rkarl2/Zyqn-7000-test/pcb/zynq_test/zynqGerbers/Required_impedance_control.xlsx

Signal Layer | Reference Layer | Impedance Type | Trace Width（mil) | Trace Spacing（mil) | Impedance(ohm)±10% | Position
L1 | L2 | Differential Pair (Non coplanar) | 4.35039 | 11.81102 | 100
L8 | L7 | Differential Pair (Non coplanar) | 4.35039 | 11.81102 | 100
L1 | L2 | Differential Pair (Non coplanar) | 5.35039 | 11.81102 | 90
L1 | L2 | Differential Pair (Non coplanar) | 5.85827 | 5.90551 | 80
L8 | L7 | Differential Pair (Non coplanar) | 5.85827 | 5.90551 | 80
L8 | L7 | Single Ended (Non coplanar) | 7.25984 |  | 40
L1 | L2 | Single Ended (Non coplanar) | 7.25984 |  | 40
L6 | L5/7 | Single Ended (Non coplanar) | 4.45 |  | 40
L4 | L5/3 | Single Ended (Non coplanar) | 4.45 |  | 40
L8 | L7 | Single Ended (Non coplanar) | 4.66142 |  | 50
L1 | L2 | Single Ended (Non coplanar) | 4.66142 |  | 50
