rkarl2/Zyqn-7000-test/pcb/zynq_test/zynq_test.kicad_pcb

## KiCad design pcb/zynq_test/zynq_test.kicad_pcb (2025-10-05)

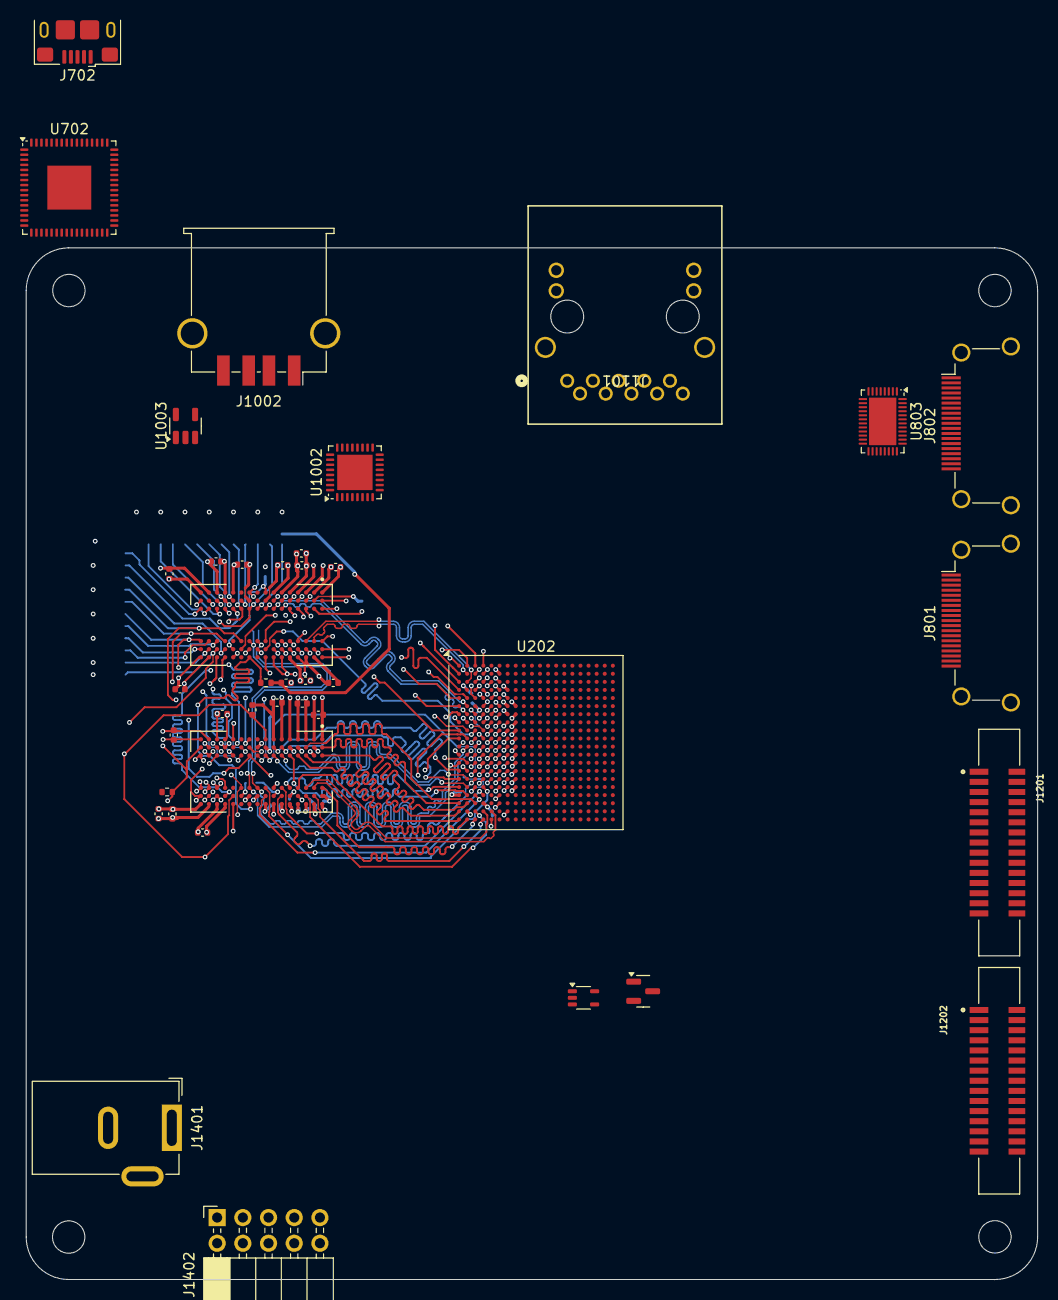
[picture p3: board zynq_test.kicad_pcb from above]

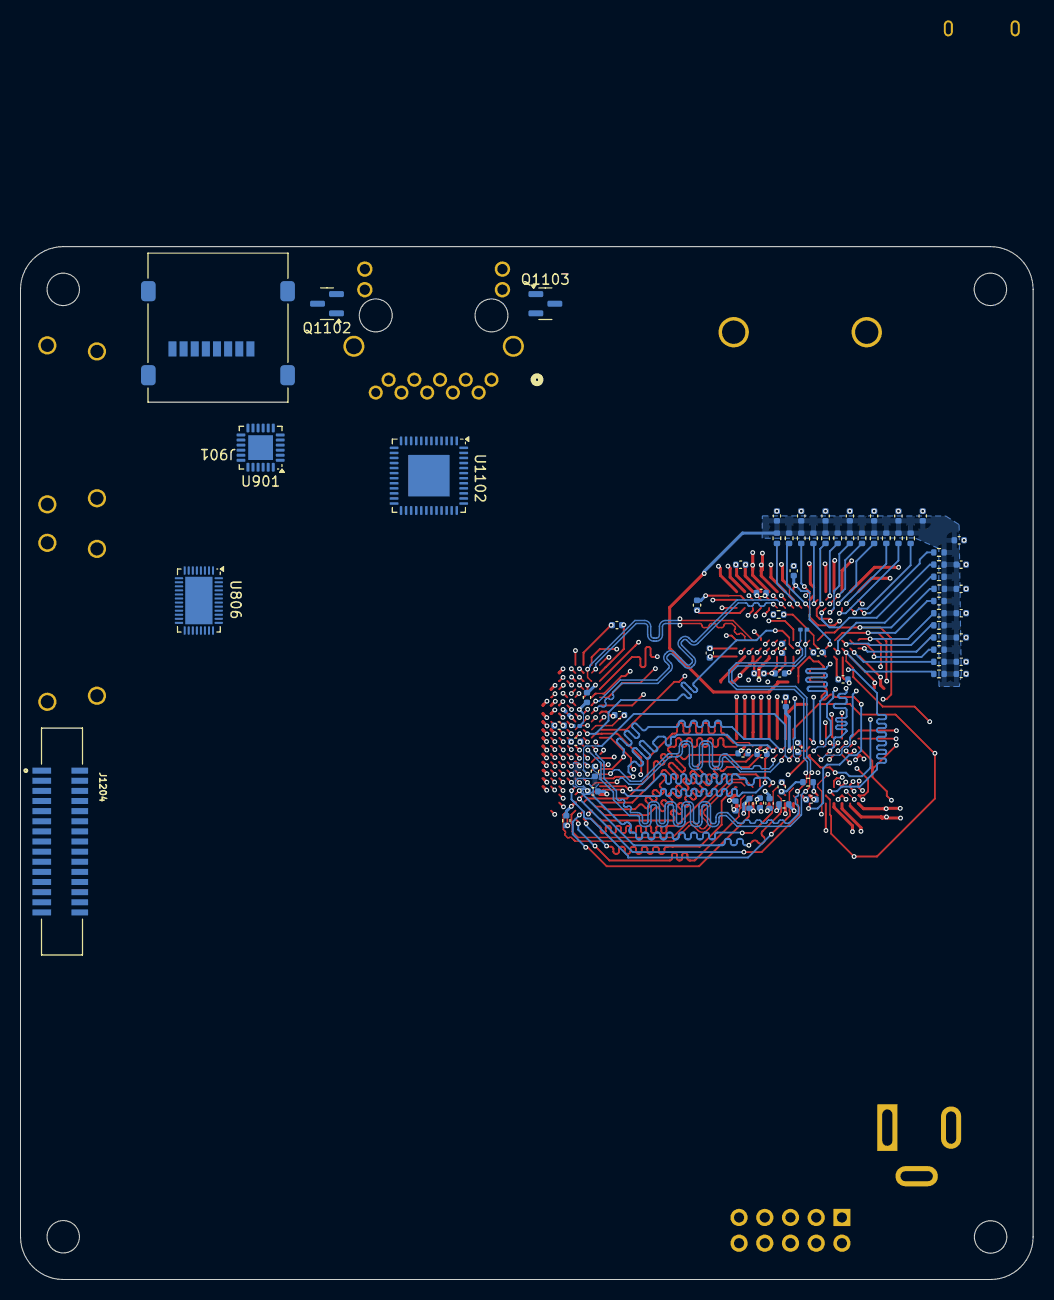
[picture p4: board zynq_test.kicad_pcb from below]

Board: 8 copper layers, 100.0 x 102.0 mm, 118 parts (78 on the bottom side), 203 nets.

Parts:
C401, C403, C406, C409, C411, C501, C502, C537, C538, C617, C620, C622, C624: 470n; C_0402_1005Metric
C402, C405, C408, C412, C415, C416, C539, C540, C627, C630: 4u7; C_0402_1005Metric
C404, C407, C410, C413, C414: 100n; C_0402_1005Metric
C503, C504, C505, C506, C507, C508, C509, C510, C511, C512, C513, C514, C515, C516, C517, C518, C519, C520, C521, C522, C523, C524, C525, C526, C527, C528, C530, C532, C533, C534, C535, C536: 47n; C_0402_1005Metric
C529, C531: 10n; C_0402_1005Metric
C632: 100u; C_0402_1005Metric
J702: USB_B_Micro; USB_Micro-B_Amphenol_10118193-0001LF_Horizontal
J801, J802: HDMI_A; HDMI_A_Amphenol_10029449-x01xLF_Horizontal
J901: A-MicroTF-1.85A; microSD_HC_Molex_47219-2001
J1002: USB_A; USB_A_TE_292303-7_Horizontal
J1101: RJ45_JK0654219; ARJM11C7-502-AB-ER2-T_ABR
J1201, J1202, J1204: 1-1734248-5; TE_1-1734248-5
J1401: Barrel_Jack; BarrelJack_GCT_DCJ200-10-A_Horizontal
J1402: Conn_02x05_Odd_Even; PinSocket_2x05_P2.54mm_Horizontal
Q1102, Q1103, Q1104: 2N7002E; SOT-23
R401, R402, R406: 80R; R_0201_0603Metric
R403: 4k7; R_0402_1005Metric
R404, R405: 240R; R_0402_1005Metric
R407, R408, R409, R410, R411, R412, R413, R414, R415, R416, R417, R418, R419, R420, R421, R422, R423, R424, R425, R426, R427, R428, R429, R430: 40R; R_0402_1005Metric
U202: XC7Z020-2CLG400I; Zynq_Z7020-2CLG400I_W_Delay
U401, U402: MT41K256M16TW-107; BGA96C80P9X16_1400X800X120_pinDelays
U702: FT2232HQ; QFN-64-1EP_9x9mm_P0.5mm_EP4.35x4.35mm
U803, U806: TDP1204RNQR; Texas_RNQ0040A_WQFN-40-1EP_6x4mm_P0.4mm_EP4.7x2.7mm
U901: TXS02612RTW; WQFN-24-1EP_4x4mm_P0.5mm_EP2.45x2.45mm
U1002: TUSB1210-Q1; VQFN-32-1EP_5x5mm_P0.5mm_EP3.5x3.5mm
U1003: AP22816AKBWT; SOT-23-5
U1102: LAN8830; VQFN-48-1EP_7x7mm_P0.5mm_EP4.1x4.1mm
U1405: 74LVC1G17; Texas_R-PDSO-G5_DCK-5

Connections:
+1V0: J1402.4, U202.G7 (VCCPINT), U202.G11 (VCCBRAM), U202.G13 (VCCINT), U202.H10 (VCCBRAM), U202.H12 (VCCINT), U202.J7 (VCCPINT), U202.J13 (VCCINT), U202.K12 (VCCINT), U202.L7 (VCCPINT), U202.L13 (VCCINT), U202.M12 (VCCINT), U202.N7 (VCCPINT), U202.N13 (VCCINT), U202.P8 (VCCPINT), U202.P12 (VCCINT), U202.R7 (VCCPINT), U202.R13 (VCCINT)
+1V8: J1402.6, U202.A13 (VCCO_MIO1_501), U202.B16 (VCCO_MIO1_501), U202.D12 (VCCO_MIO1_501), U202.E15 (VCCO_MIO1_501), U202.F8 (VCCPAUX), U202.G9 (VCCPAUX), U202.H8 (VCCPAUX), U202.J9 (VCCADC_0), U202.J11 (VCCAUX), U202.K8 (VCCPAUX), U202.L11 (VCCAUX), U202.M8 (VCCPAUX), U202.N9 (VCCAUX), U202.N11 (VCCAUX), U202.P10 (VCCAUX), U202.R9 (VCCAUX), U202.T8 (VCCO_13), U202.U11 (VCCO_13), U202.W7 (VCCO_13), U202.Y10 (VCCO_13), U901.5 (V_{CCA}), U1002.11 (CS), U1002.14 (CFG), U1002.27 (RESETB), U1002.28 (V_{DD18}), U1002.30 (V_{DD18}), U1002.32 (V_{DDIO}), U1102.17 (VDDIO), U1102.24 (VDDIO), U1102.28 (VDDIO), U1102.35 (VDDIO), U1102.41 (VDDIO)
+1V8_FTDI: U702.12 (VCORE), U702.37 (VCORE), U702.49 (VREGOUT), U702.64 (VCORE)
+1V35: C501.1, C502.1, C503.1, C504.1, C505.1, C506.1, C507.1, C508.1, C509.1, C510.1, C511.1, C512.1, C513.1, C514.1, C515.1, C516.1, C517.1, C518.1, C519.1, C520.1, C521.1, C522.1, C523.1, C524.1, C525.1, C526.1, C527.1, C528.1, C530.1, C532.1, C533.1, C534.1, C535.1, C536.1, C537.1, C538.1, C539.1, C540.1, C617.1, C620.1, C622.1, C624.1, C627.1, C630.1, C632.1, J1402.8, R401.1, U202.A3 (VCCO_DDR_502), U202.D2 (VCCO_DDR_502), U202.E5 (VCCO_DDR_502), U202.G1 (VCCO_DDR_502), U202.H4 (VCCO_DDR_502), U202.L3 (VCCO_DDR_502), U202.P2 (VCCO_DDR_502), U202.R5 (VCCO_DDR_502), U202.U1 (VCCO_DDR_502), U202.V4 (VCCO_DDR_502), U401.A1 (VDDQ), U401.A8 (VDDQ), U401.B2 (VDD), U401.C1 (VDDQ), U401.C9 (VDDQ), U401.D2 (VDDQ), U401.D9 (VDD), U401.E9 (VDDQ), U401.F1 (VDDQ), U401.G7 (VDD), U401.H2 (VDDQ), U401.H9 (VDDQ), U401.K2 (VDD), U401.K8 (VDD), U401.N1 (VDD), U401.N9 (VDD), U401.R1 (VDD), U401.R9 (VDD), U402.A1 (VDDQ), U402.A8 (VDDQ), U402.B2 (VDD), U402.C1 (VDDQ), U402.C9 (VDDQ), U402.D2 (VDDQ), U402.D9 (VDD), U402.E9 (VDDQ), U402.F1 (VDDQ), U402.G7 (VDD), U402.H2 (VDDQ), U402.H9 (VDDQ), U402.K2 (VDD), U402.K8 (VDD), U402.N1 (VDD), U402.N9 (VDD), U402.R1 (VDD), U402.R9 (VDD)
+3V3: J901.4 (VDD), J1101.11 (L_LED_A), J1101.13 (R_LED_A), J1201.15, J1201.15_1 (15__1), J1202.15, J1202.15_1 (15__1), J1204.15, J1204.15_1 (15__1), J1402.10, U202.B6 (VCCO_MIO0_500), U202.C19 (VCCO_35), U202.D7 (VCCO_MIO0_500), U202.F18 (VCCO_35), U202.H14 (VCCO_35), U202.J17 (VCCO_35), U202.K6 (VCCO_0), U202.K20 (VCCO_35), U202.M6 (CFGBVS_0), U202.M16 (VCCO_35), U202.N6 (RSVDVCC3), U202.N19 (VCCO_34), U202.R6 (RSVDVCC2), U202.R15 (VCCO_34), U202.T6 (RSVDVCC1), U202.T18 (VCCO_34), U202.V14 (VCCO_34), U202.W17 (VCCO_34), U202.Y20 (VCCO_34), U702.20 (VCCIO), U702.31 (VCCIO), U702.42 (VCCIO), U702.50 (VREGIN), U702.56 (VCCIO), U803.1 (VCC), U803.6 (VCC), U803.14 (VIO), U803.20 (VCC), U803.28 (VCC), U806.1 (VCC), U806.6 (VCC), U806.14 (VIO), U806.20 (VCC), U806.28 (VCC), U901.17 (VCC_{B1}), U901.21 (VCC_{B0}), U1002.20 (V_{DD33}), U1002.21 (V_{BAT}), U1405.5 (VCC)
+5V: J801.18 (+5V), J802.18 (+5V), J1402.2, U1003.3 (IN)
+5V_{USB_OTG}: J1002.1 (VBUS), U1002.22 (V_{BUS}), U1003.1 (OUT), U1003.5 (OUT)
+V_{TT} 0V675: C402.1, C403.1, C404.1, C405.1, C406.1, C407.1, C408.1, C409.1, C410.1, C411.1, C412.1, C413.1, C414.1, C415.1, C416.1, R407.1, R408.1, R409.1, R410.1, R411.1, R412.1, R413.1, R414.1, R415.1, R416.1, R417.1, R418.1, R419.1, R420.1, R421.1, R422.1, R423.1, R424.1, R425.1, R426.1, R427.1, R428.1, R429.1, R430.1
/Boot/SD0.CLK: J901.5 (CLK), U901.9 (CLKA), U901.19 (CLK_{B0})
/Boot/SD0.CMD: J901.3 (CMD), U202.C17 (PS_MIO41_501), U901.4 (CMDA), U901.20 (CMD_{B0})
/Boot/SD0.DAT0: J901.7 (DAT0), U901.18 (DAT0_{B0})
/Boot/SD0.DAT1: J901.8 (DAT1), U901.16 (DAT1_{B0})
/Boot/SD0.DAT2: J901.1 (DAT2), U901.23 (DAT2_{B0})
/Boot/SD0.DAT3: J901.2 (DAT3/CD), U901.22 (DAT3_{B0})
/Boot/SD0.DATA-0: U202.E12 (PS_MIO42_501), U901.6 (DAT0A)
/Boot/SD0.DATA-1: U202.A9 (PS_MIO43_501), U901.7 (DAT1A)
/Boot/SD0.DATA-2: U202.F13 (PS_MIO44_501), U901.1 (DAT2A)
/Boot/SD0.DATA-3: U202.B15 (PS_MIO45_501), U901.3 (DAT3A)
/Cameras/CAM0.GPIO1.: J1201.11, J1201.11_1 (11__1), J1201.12, J1201.12_1 (12__1)
/Cameras/CAM1.GPIO1.: J1202.11, J1202.11_1 (11__1), J1202.12, J1202.12_1 (12__1)
/Cameras/CAM2.GPIO1.: J1204.11, J1204.11_1 (11__1), J1204.12, J1204.12_1 (12__1)
/Cameras/CAM2.TX.0_N: J1204.2, J1204.2_1 (2__1)
/Cameras/CAM2.TX.0_P: J1204.3, J1204.3_1 (3__1)
/Cameras/CAM2.TX.1_N: J1204.5, J1204.5_1 (5__1)
/Cameras/CAM2.TX.1_P: J1204.6, J1204.6_1 (6__1)
/Cameras/CAM2.TX.CLK_N: J1204.8, J1204.8_1 (8__1)
/Cameras/CAM2.TX.CLK_P: J1204.9, J1204.9_1 (9__1)
/Cameras/CAM_RX.0.CAM_CLK_N: J1201.8, J1201.8_1 (8__1), U202.L20 (IO_L9N_T1_DQS_AD3N_35)
/Cameras/CAM_RX.0.CAM_CLK_P: J1201.9, J1201.9_1 (9__1), U202.L19 (IO_L9P_T1_DQS_AD3P_35)
/Cameras/CAM_RX.0.CAM_D0_N: J1201.2, J1201.2_1 (2__1), U202.F20 (IO_L15N_T2_DQS_AD12N_35)
/Cameras/CAM_RX.0.CAM_D0_P: J1201.3, J1201.3_1 (3__1), U202.F19 (IO_L15P_T2_DQS_AD12P_35)
/Cameras/CAM_RX.0.CAM_D1_N: J1201.5, J1201.5_1 (5__1), U202.H20 (IO_L17N_T2_AD5N_35)
/Cameras/CAM_RX.0.CAM_D1_P: J1201.6, J1201.6_1 (6__1), U202.J20 (IO_L17P_T2_AD5P_35)
/Cameras/CAM_RX.0.I2C_CLK: J1201.13, J1201.13_1 (13__1), U202.K17 (IO_L12P_T1_MRCC_35)
/Cameras/CAM_RX.0.I2C_SDA: J1201.14, J1201.14_1 (14__1), U202.K18 (IO_L12N_T1_MRCC_35)
/Cameras/CAM_RX.1.CAM_CLK_N: J1202.8, J1202.8_1 (8__1), U202.W15 (IO_L10N_T1_34)
/Cameras/CAM_RX.1.CAM_CLK_P: J1202.9, J1202.9_1 (9__1), U202.V15 (IO_L10P_T1_34)
/Cameras/CAM_RX.1.CAM_D0_N: J1202.2, J1202.2_1 (2__1), U202.Y19 (IO_L17N_T2_34)
/Cameras/CAM_RX.1.CAM_D0_P: J1202.3, J1202.3_1 (3__1), U202.Y18 (IO_L17P_T2_34)
/Cameras/CAM_RX.1.CAM_D1_N: J1202.5, J1202.5_1 (5__1), U202.Y17 (IO_L7N_T1_34)
/Cameras/CAM_RX.1.CAM_D1_P: J1202.6, J1202.6_1 (6__1), U202.Y16 (IO_L7P_T1_34)
/Cameras/CAM_RX.1.I2C_CLK: J1202.13, J1202.13_1 (13__1), U202.V20 (IO_L16P_T2_34)
/Cameras/CAM_RX.1.I2C_SDA: J1202.14, J1202.14_1 (14__1), U202.W20 (IO_L16N_T2_34)
/Cameras/CAM_TX.2.I2C_CLK: J1204.13, J1204.13_1 (13__1), U202.T14 (IO_L5P_T0_34)
/Cameras/CAM_TX.2.I2C_SDA: J1204.14, J1204.14_1 (14__1), U202.T15 (IO_L5N_T0_34)
/ETHERNET/ETH0.MDC: U202.C10 (PS_MIO52_501), U1102.37 (MDC)
/ETHERNET/ETH0.MDIO: U202.C11 (PS_MIO53_501), U1102.38 (MDIO)
/ETHERNET/ETH0_INT: U202.K14 (IO_L20P_T3_AD6P_35), U1102.39 (INT_N/GPIO5)
/ETHERNET/ETH_1V1: U1102.4 (VDDAL), U1102.9 (VDDAL), U1102.47 (VDDAL_PLL)
/ETHERNET/ETH_A_3V3: U1102.1 (VDDAH), U1102.12 (VDDAH)
/ETHERNET/ETH_TX1_N: J1101.2 (TRD1-), U1102.3 (TXRXM_A)
/ETHERNET/ETH_TX1_P: J1101.1 (TRD1+), U1102.2 (TXRXP_A)
/ETHERNET/ETH_TX2_N: J1101.4 (TRD2-), U1102.6 (TXRXM_B)
/ETHERNET/ETH_TX2_P: J1101.3 (TRD2+), U1102.5 (TXRXP_B)
/ETHERNET/ETH_TX3_N: J1101.8 (TRD3-), U1102.8 (TXRXM_C)
/ETHERNET/ETH_TX3_P: J1101.7 (TRD3+), U1102.7 (TXRXP_C)
/ETHERNET/ETH_TX4_N: J1101.10 (TRD4-), U1102.11 (TXRXM_D)
/ETHERNET/ETH_TX4_P: J1101.9 (TRD4+), U1102.10 (TXRXP_D)
/ETHERNET/ETH_VDD_1V1: U1102.23 (VDD), U1102.27 (VDD), U1102.31 (VDD), U1102.40 (VDD)
/HDMI/HDMI.CTR.SCL: U202.J16 (IO_L24N_T3_AD15N_35), U803.21 (SCL/CFG0), U806.21 (SCL/CFG0)
/HDMI/HDMI.CTR.SDA: U202.K16 (IO_L24P_T3_AD15P_35), U803.22 (SDA/CFG1), U806.22 (SDA/CFG1)
/HDMI/HDMI.EN: U202.L16 (IO_L11P_T1_SRCC_35), U803.7 (EN), U806.7 (EN)
/HDMI/HDMI.RX.CLK_N: U202.G18 (IO_L16N_T2_35), U806.30 (OUT_CLKN)
/HDMI/HDMI.RX.CLK_P: U202.G17 (IO_L16P_T2_35), U806.31 (OUT_CLKP)
/HDMI/HDMI.RX.D0_N: U202.G15 (IO_L19N_T3_VREF_35), U806.33 (OUT_D0N)
/HDMI/HDMI.RX.D0_P: U202.H15 (IO_L19P_T3_35), U806.34 (OUT_D0P)
/HDMI/HDMI.RX.D1_N: U202.F17 (IO_L6N_T0_VREF_35), U806.36 (OUT_D1N)
/HDMI/HDMI.RX.D1_P: U202.F16 (IO_L6P_T0_35), U806.37 (OUT_D1P)
/HDMI/HDMI.RX.D2_N: U202.D18 (IO_L3N_T0_DQS_AD1N_35), U806.39 (OUT_D2N)
/HDMI/HDMI.RX.D2_P: U202.E17 (IO_L3P_T0_DQS_AD1P_35), U806.40 (OUT_D2P)
/HDMI/HDMI.RX.SCL: U202.J18 (IO_L14P_T2_AD4P_SRCC_35), U806.24 (LV_DDC_SCL)
/HDMI/HDMI.RX.SDA: U202.H18 (IO_L14N_T2_AD4N_SRCC_35), U806.25 (LV_DDC_SDA)
/HDMI/HDMI.TX.CLK_N: U202.E19 (IO_L5N_T0_AD9N_35), U803.19 (IN_CLKN)
/HDMI/HDMI.TX.CLK_P: U202.E18 (IO_L5P_T0_AD9P_35), U803.18 (IN_CLKP)
/HDMI/HDMI.TX.D0_N: U202.D20 (IO_L4N_T0_35), U803.16 (IN_D0N)
/HDMI/HDMI.TX.D0_P: U202.D19 (IO_L4P_T0_35), U803.15 (IN_D0P)
/HDMI/HDMI.TX.D1_N: U202.B20 (IO_L1N_T0_AD0N_35), U803.13 (IN_D1N)
/HDMI/HDMI.TX.D1_P: U202.C20 (IO_L1P_T0_AD0P_35), U803.12 (IN_D1P)
/HDMI/HDMI.TX.D2_N: U202.A20 (IO_L2N_T0_AD8N_35), U803.10 (IN_D2N)
/HDMI/HDMI.TX.D2_P: U202.B19 (IO_L2P_T0_AD8P_35), U803.9 (IN_D2P)
/HDMI/HDMI.TX.HDP: U202.J14 (IO_L20N_T3_AD6N_35), U803.32 (HPD_IN)
/HDMI/HDMI.TX.SCL: U202.G14 (IO_0_35), U803.24 (LV_DDC_SCL)
/HDMI/HDMI.TX.SDA: U202.J15 (IO_25_35), U803.25 (LV_DDC_SDA)
/HDMI/HDMI_SHIELD: J801.SH, J802.SH
/Power/PWR_ON_RST: Q1104.1 (G), U202.C7 (PS_POR_B_500), U1405.4
/Programmer/FTDI_D+: J702.3 (D+), U702.8 (DP)
/Programmer/FTDI_D-: J702.2 (D-), U702.7 (DM)
/USB_OTG/USB0.DATA-0: U202.A14 (PS_MIO32_501), U1002.3 (DATA0)
/USB_OTG/USB0.DATA-1: U202.D15 (PS_MIO33_501), U1002.4 (DATA1)
/USB_OTG/USB0.DATA-2: U202.A12 (PS_MIO34_501), U1002.5 (DATA2)
/USB_OTG/USB0.DATA-3: U202.F12 (PS_MIO35_501), U1002.6 (DATA3)
/USB_OTG/USB0.DATA-4: U202.C16 (PS_MIO28_501), U1002.7 (DATA4)
/USB_OTG/USB0.DATA-5: U202.A10 (PS_MIO37_501), U1002.9 (DATA5)
/USB_OTG/USB0.DATA-6: U202.E13 (PS_MIO38_501), U1002.10 (DATA6)
/USB_OTG/USB0.DATA-7: U202.C18 (PS_MIO39_501), U1002.13 (DATA7)
/USB_OTG/USB0.DIR: U202.C13 (PS_MIO29_501), U1002.31 (DIR)
/USB_OTG/USB0.NXT: U202.E16 (PS_MIO31_501), U1002.2 (NXT)
/USB_OTG/USB0.STP: U202.C15 (PS_MIO30_501), U1002.29 (STP)
/USB_OTG/USB_OTG.D+: J1002.3 (D+), U1002.18 (DP)
/USB_OTG/USB_OTG.D-: J1002.2 (D-), U1002.19 (DM)
/Zynq Dram/DDR_ADDR0: R407.2, U202.N2 (PS_DDR_A0_502), U401.N3 (A0), U402.N3 (A0)
/Zynq Dram/DDR_ADDR1: R409.2, U202.K2 (PS_DDR_A1_502), U401.P7 (A1), U402.P7 (A1)
/Zynq Dram/DDR_ADDR2: R412.2, U202.M3 (PS_DDR_A2_502), U401.P3 (A2), U402.P3 (A2)
/Zynq Dram/DDR_ADDR3: R415.2, U202.K3 (PS_DDR_A3_502), U401.N2 (A3), U402.N2 (A3)
/Zynq Dram/DDR_ADDR4: R418.2, U202.M4 (PS_DDR_A4_502), U401.P8 (A4), U402.P8 (A4)
/Zynq Dram/DDR_ADDR5: R421.2, U202.L1 (PS_DDR_A5_502), U401.P2 (A5), U402.P2 (A5)
/Zynq Dram/DDR_ADDR6: R424.2, U202.L4 (PS_DDR_A6_502), U401.R8 (A6), U402.R8 (A6)
/Zynq Dram/DDR_ADDR7: R427.2, U202.K4 (PS_DDR_A7_502), U401.R2 (A7), U402.R2 (A7)
/Zynq Dram/DDR_ADDR8: R408.2, U202.K1 (PS_DDR_A8_502), U401.T8 (A8), U402.T8 (A8)
/Zynq Dram/DDR_ADDR9: R410.2, U202.J4 (PS_DDR_A9_502), U401.R3 (A9), U402.R3 (A9)
/Zynq Dram/DDR_ADDR10: R413.2, U202.F5 (PS_DDR_A10_502), U401.L7 (A10/AP), U402.L7 (A10/AP)
/Zynq Dram/DDR_ADDR11: R416.2, U202.G4 (PS_DDR_A11_502), U401.R7 (A11), U402.R7 (A11)
/Zynq Dram/DDR_ADDR12: R419.2, U202.E4 (PS_DDR_A12_502), U401.N7 (A12/~BC), U402.N7 (A12/~BC)
/Zynq Dram/DDR_ADDR13: R422.2, U202.D4 (PS_DDR_A13_502), U401.T3 (A13), U402.T3 (A13)
/Zynq Dram/DDR_ADDR14: R425.2, U202.F4 (PS_DDR_A14_502), U401.T7 (A14), U402.T7 (A14)
/Zynq Dram/DDR_CTR.BA0: R428.2, U202.L5 (PS_DDR_BA0_502), U401.M2 (BA0), U402.M2 (BA0)
/Zynq Dram/DDR_CTR.BA1: R429.2, U202.R4 (PS_DDR_BA1_502), U401.N8 (BA1), U402.N8 (BA1)
/Zynq Dram/DDR_CTR.BA2: R430.2, U202.J5 (PS_DDR_BA2_502), U401.M3 (BA2), U402.M3 (BA2)
/Zynq Dram/DDR_CTR.CAS: R414.2, U202.P5 (PS_DDR_CAS_B_502), U401.K3 (~CAS), U402.K3 (~CAS)
/Zynq Dram/DDR_CTR.CLK_E: R411.2, U202.N3 (PS_DDR_CKE_502), U401.K9 (CKE), U402.K9 (CKE)
/Zynq Dram/DDR_CTR.CLK_N: R406.2, U202.M2 (PS_DDR_CKN_502), U401.K7 (~CK), U402.K7 (~CK)
/Zynq Dram/DDR_CTR.CLK_P: R406.1, U202.L2 (PS_DDR_CKP_502), U401.J7 (CK), U402.J7 (CK)
/Zynq Dram/DDR_CTR.CS: R417.2, U202.N1 (PS_DDR_CS_B_502), U401.L2 (~CS), U402.L2 (~CS)
/Zynq Dram/DDR_CTR.ODT: R420.2, U202.N5 (PS_DDR_ODT_502), U401.K1 (ODT), U402.K1 (ODT)
/Zynq Dram/DDR_CTR.RAS: R423.2, U202.P4 (PS_DDR_RAS_B_502), U401.J3 (~RAS), U402.J3 (~RAS)
/Zynq Dram/DDR_CTR.RST: R403.1, U202.B4 (PS_DDR_DRST_B_502), U401.T2 (~RESET), U402.T2 (~RESET)
/Zynq Dram/DDR_CTR.WE: R426.2, U202.M5 (PS_DDR_WE_B_502), U401.L3 (~WE), U402.L3 (~WE)
/Zynq Dram/DDR_L0.0: U202.C3 (PS_DDR_DQ0_502), U401.D7 (DQ8)
/Zynq Dram/DDR_L0.1: U202.B3 (PS_DDR_DQ1_502), U401.A2 (DQ13)
/Zynq Dram/DDR_L0.2: U202.A2 (PS_DDR_DQ2_502), U401.A3 (DQ15)
/Zynq Dram/DDR_L0.3: U202.A4 (PS_DDR_DQ3_502), U401.C2 (DQ11)
/Zynq Dram/DDR_L0.4: U202.D3 (PS_DDR_DQ4_502), U401.B8 (DQ14)
/Zynq Dram/DDR_L0.5: U202.D1 (PS_DDR_DQ5_502), U401.A7 (DQ12)
/Zynq Dram/DDR_L0.6: U202.C1 (PS_DDR_DQ6_502), U401.C3 (DQ9)
/Zynq Dram/DDR_L0.7: U202.E1 (PS_DDR_DQ7_502), U401.C8 (DQ10)
/Zynq Dram/DDR_L0.DM: U202.A1 (PS_DDR_DM0_502), U401.D3 (UDM)
/Zynq Dram/DDR_L0.DQS_N: U202.B2 (PS_DDR_DQS_N0_502), U401.B7 (~UDQS)
/Zynq Dram/DDR_L0.DQS_P: U202.C2 (PS_DDR_DQS_P0_502), U401.C7 (UDQS)
/Zynq Dram/DDR_L1.8: U202.E2 (PS_DDR_DQ8_502), U401.H3 (DQ4)
/Zynq Dram/DDR_L1.9: U202.E3 (PS_DDR_DQ9_502), U401.G2 (DQ6)
/Zynq Dram/DDR_L1.10: U202.G3 (PS_DDR_DQ10_502), U401.F2 (DQ2)
/Zynq Dram/DDR_L1.11: U202.H3 (PS_DDR_DQ11_502), U401.E3 (DQ0)
/Zynq Dram/DDR_L1.12: U202.J3 (PS_DDR_DQ12_502), U401.H8 (DQ5)
/Zynq Dram/DDR_L1.13: U202.H2 (PS_DDR_DQ13_502), U401.F7 (DQ1)
/Zynq Dram/DDR_L1.14: U202.H1 (PS_DDR_DQ14_502), U401.F8 (DQ3)
/Zynq Dram/DDR_L1.15: U202.J1 (PS_DDR_DQ15_502), U401.H7 (DQ7)
/Zynq Dram/DDR_L1.DM: U202.F1 (PS_DDR_DM1_502), U401.E7 (LDM)
/Zynq Dram/DDR_L1.DQS_N: U202.F2 (PS_DDR_DQS_N1_502), U401.G3 (~LDQS)
/Zynq Dram/DDR_L1.DQS_P: U202.G2 (PS_DDR_DQS_P1_502), U401.F3 (LDQS)
/Zynq Dram/DDR_L2.16: U202.P1 (PS_DDR_DQ16_502), U402.G2 (DQ6)
/Zynq Dram/DDR_L2.17: U202.P3 (PS_DDR_DQ17_502), U402.H3 (DQ4)
/Zynq Dram/DDR_L2.18: U202.R3 (PS_DDR_DQ18_502), U402.F7 (DQ1)
/Zynq Dram/DDR_L2.19: U202.R1 (PS_DDR_DQ19_502), U402.F2 (DQ2)
/Zynq Dram/DDR_L2.20: U202.T4 (PS_DDR_DQ20_502), U402.H7 (DQ7)
/Zynq Dram/DDR_L2.21: U202.U4 (PS_DDR_DQ21_502), U402.F8 (DQ3)
/Zynq Dram/DDR_L2.22: U202.U2 (PS_DDR_DQ22_502), U402.E3 (DQ0)
/Zynq Dram/DDR_L2.23: U202.U3 (PS_DDR_DQ23_502), U402.H8 (DQ5)
/Zynq Dram/DDR_L2.DM: U202.T1 (PS_DDR_DM2_502), U402.E7 (LDM)
/Zynq Dram/DDR_L2.DQS_N: U202.T2 (PS_DDR_DQS_N2_502), U402.G3 (~LDQS)
/Zynq Dram/DDR_L2.DQS_P: U202.R2 (PS_DDR_DQS_P2_502), U402.F3 (LDQS)
/Zynq Dram/DDR_L3.24: U202.V1 (PS_DDR_DQ24_502), U402.A2 (DQ13)
/Zynq Dram/DDR_L3.25: U202.Y3 (PS_DDR_DQ25_502), U402.A7 (DQ12)
/Zynq Dram/DDR_L3.26: U202.W1 (PS_DDR_DQ26_502), U402.C3 (DQ9)
/Zynq Dram/DDR_L3.27: U202.Y4 (PS_DDR_DQ27_502), U402.B8 (DQ14)
/Zynq Dram/DDR_L3.28: U202.Y2 (PS_DDR_DQ28_502), U402.D7 (DQ8)
/Zynq Dram/DDR_L3.29: U202.W3 (PS_DDR_DQ29_502), U402.C8 (DQ10)
/Zynq Dram/DDR_L3.30: U202.V2 (PS_DDR_DQ30_502), U402.A3 (DQ15)
/Zynq Dram/DDR_L3.31: U202.V3 (PS_DDR_DQ31_502), U402.C2 (DQ11)
/Zynq Dram/DDR_L3.DM: U202.Y1 (PS_DDR_DM3_502), U402.D3 (UDM)
/Zynq Dram/DDR_L3.DQS_N: U202.W5 (PS_DDR_DQS_P3_502), U402.B7 (~UDQS)
/Zynq Dram/DDR_L3.DQS_P: U202.W4 (PS_DDR_DQS_N3_502), U402.C7 (UDQS)
/Zynq FPGA/CLK_125M: U202.H16 (IO_L13P_T2_MRCC_35), U1102.42 (CLK125_NDO/GPIO6/LED_MODE)
GND: C401.2, C402.2, C403.2, C404.2, C405.2, C406.2, C407.2, C408.2, C409.2, C410.2, C411.2, C412.2, C413.2, C414.2, C415.2, C416.2, C501.2, C502.2, C503.2, C504.2, C505.2, C506.2, C507.2, C508.2, C509.2, C510.2, C511.2, C512.2, C513.2, C514.2, C515.2, C516.2, C517.2, C518.2, C519.2, C520.2, C521.2, C522.2, C523.2, C524.2, C525.2, C526.2, C527.2, C528.2, C529.2, C530.2, C531.2, C532.2, C533.2, C534.2, C535.2, C536.2, C537.2, C538.2, C539.2, C540.2, C617.2, C620.2, C622.2, C624.2, C627.2, C630.2, C632.2, J702.5 (GND), J801.2 (D2S), J801.5 (D1S), J801.8 (D0S), J801.11 (CKS), J801.17 (GND), J802.2 (D2S), J802.5 (D1S), J802.8 (D0S), J802.11 (CKS), J802.17 (GND), J901.6 (VSS), J1002.4 (GND), J1002.5 (Shield), J1201.1, J1201.1_1 (1__1), J1201.4, J1201.4_1 (4__1), J1201.7, J1201.7_1 (7__1), J1201.10, J1201.10_1 (10__1), J1202.1, J1202.1_1 (1__1), J1202.4, J1202.4_1 (4__1), J1202.7, J1202.7_1 (7__1), J1202.10, J1202.10_1 (10__1), J1204.1, J1204.1_1 (1__1), J1204.4, J1204.4_1 (4__1), J1204.7, J1204.7_1 (7__1), J1204.10, J1204.10_1 (10__1), J1401.2, Q1102.2 (S), Q1103.2 (S), Q1104.2 (S), R402.2, R403.2, R404.2, R405.2, U202.A8 (GND), U202.A18 (GND), U202.B1 (GND), U202.B11 (GND), U202.C4 (GND), U202.C9 (GND), U202.C14 (GND), U202.D17 (GND), U202.E10 (GND), U202.E20 (GND), U202.F3 (GND), U202.F7 (GND), U202.F10 (RSVDGND), U202.F11 (VCCBATT_0), U202.G10 (GND), U202.G12 (GND), U202.G16 (GND), U202.H7 (GND), U202.H9 (GND), U202.H11 (GND), U202.H13 (GND), U202.H19 (GND), U202.J2 (GND), U202.J8 (GND), U202.J10 (GNDADC_0), U202.J12 (GND), U202.K5 (GND), U202.K7 (GND), U202.K10 (VREFN_0), U202.K11 (GND), U202.K13 (GND), U202.K15 (GND), U202.L8 (GND), U202.L9 (VREFP_0), U202.L10 (VN_0), U202.L12 (GND), U202.L18 (GND), U202.M1 (GND), U202.M7 (GND), U202.M9 (DXP_0), U202.M10 (DXN_0), U202.M11 (GND), U202.M13 (GND), U202.N4 (GND), U202.N8 (GND), U202.N10 (GND), U202.N12 (GND), U202.N14 (GND), U202.P7 (GND), U202.P9 (GND), U202.P11 (GND), U202.P13 (GND), U202.P17 (GND), U202.R8 (GND), U202.R12 (GND), U202.R20 (GND), U202.T3 (GND), U202.T7 (GND), U202.T13 (GND), U202.U6 (GND), U202.U16 (GND), U202.V9 (GND), U202.V19 (GND), U202.W2 (GND), U202.W12 (GND), U202.Y5 (GND), U202.Y15 (GND), U401.A9 (VSS), U401.B1 (VSSQ), U401.B3 (VSS), U401.B9 (VSSQ), U401.D1 (VSSQ), U401.D8 (VSSQ), U401.E1 (VSS), U401.E2 (VSSQ), U401.E8 (VSSQ), U401.F9 (VSSQ), U401.G1 (VSSQ), U401.G8 (VSS), U401.G9 (VSSQ), U401.J2 (VSS), U401.J8 (VSS), U401.M1 (VSS), U401.M9 (VSS), U401.P1 (VSS), U401.P9 (VSS), U401.T1 (VSS), U401.T9 (VSS), U402.A9 (VSS), U402.B1 (VSSQ), U402.B3 (VSS), U402.B9 (VSSQ), U402.D1 (VSSQ), U402.D8 (VSSQ), U402.E1 (VSS), U402.E2 (VSSQ), U402.E8 (VSSQ), U402.F9 (VSSQ), U402.G1 (VSSQ), U402.G8 (VSS), U402.G9 (VSSQ), U402.J2 (VSS), U402.J8 (VSS), U402.M1 (VSS), U402.M9 (VSS), U402.P1 (VSS), U402.P9 (VSS), U402.T1 (VSS), U402.T9 (VSS), U702.1 (GND), U702.5 (GND), U702.10 (AGND), U702.11 (GND), U702.13 (TEST), U702.15 (GND), U702.25 (GND), U702.35 (GND), U702.47 (GND), U702.51 (GND), U702.65 (GND), U803.41 (GND), U806.41 (GND), U901.2 (GND), U901.11 (GND), U901.25 (EPAD), U1002.33 (GND), U1003.2 (GND), U1102.49 (GND), U1405.3 (GND)
unnamed: J1101.17 (Sh), J1101.18 (Sh)
unnamed: J801.10 (CK+), U806.18 (IN_CLKP)
unnamed: J801.12 (CK-), U806.19 (IN_CLKN)
unnamed: J801.7 (D0+), U806.15 (IN_D0P)
unnamed: J801.9 (D0-), U806.16 (IN_D0N)
unnamed: J801.4 (D1+), U806.12 (IN_D1P)
unnamed: J801.6 (D1-), U806.13 (IN_D1N)
unnamed: J801.1 (D2+), U806.9 (IN_D2P)
unnamed: J801.3 (D2-), U806.10 (IN_D2N)
unnamed: J801.19 (HPD), U806.32 (HPD_IN)
unnamed: J801.15 (SCL), U806.27 (HV_DDC_SCL)
unnamed: J801.16 (SDA), U806.26 (HV_DDC_SDA)
unnamed: J802.10 (CK+), U803.31 (OUT_CLKP)
unnamed: J802.12 (CK-), U803.30 (OUT_CLKN)
unnamed: J802.7 (D0+), U803.34 (OUT_D0P)
unnamed: J802.9 (D0-), U803.33 (OUT_D0N)
unnamed: J802.4 (D1+), U803.37 (OUT_D1P)
unnamed: J802.6 (D1-), U803.36 (OUT_D1N)
unnamed: J802.1 (D2+), U803.40 (OUT_D2P)
unnamed: J802.3 (D2-), U803.39 (OUT_D2N)
unnamed: J802.19 (HPD), U803.11 (HPD_OUT)
unnamed: J802.15 (SCL), U803.27 (HV_DDC_SCL)
unnamed: J802.16 (SDA), U803.26 (HV_DDC_SDA)
unnamed: J1101.5 (TRCT1), J1101.6 (TRCT2)
unnamed: R401.2, U202.G5 (PS_DDR_VRN_502)
unnamed: R402.1, U202.H5 (PS_DDR_VRP_502)
unnamed: R404.1, U401.L8 (ZQ)
unnamed: R405.1, U402.L8 (ZQ)
unnamed: U1002.17 (CPEN), U1003.4 (EN)
V_{TT 0.675} REF: C401.1, C529.1, C531.1, U202.H6 (PS_DDR_VREF0_502), U202.P6 (PS_DDR_VREF1_502), U401.H1 (VREFDQ), U401.M8 (VREFCA), U402.H1 (VREFDQ), U402.M8 (VREFCA)
