rkarl2/Zyqn-7000-test/(commit log)

2025-08-18 Almost done with PS MIO config
    [ZynqBus.kicad_sch, ZynqDram.kicad_sch, ZynqPWR+Config.kicad_sch, zynqMio.kicad_sch, zynq_test.kicad_pcb, zynq_test.kicad_sch]
2025-08-21 Changed MIO signals to Buses
    [ZynqBus.kicad_sch, zynqMio.kicad_sch, zynq_test.kicad_pcb, zynq_test.kicad_sch]
2025-08-23 Finished PS, started on PWR
    [ZynqBus.kicad_sch, ZynqDram.kicad_sch, ZynqPWR+Config.kicad_sch, zynqMio.kicad_sch, zynq_test.kicad_pcb, zynq_test.kicad_sch]
2025-08-23 Finished FPGA decouploing, and jtag programmer
    [ZynqBus.kicad_sch, ZynqDram.kicad_sch, ZynqPWR+Config.kicad_sch, programmer.kicad_sch, zynqMio.kicad_sch, zynq_test.kicad_sch]
2025-08-24 Finished boot media, added structure for IO
    [Boot.kicad_sch, Cameras.kicad_sch, HDMI.kicad_sch, ZynqDram.kicad_sch, eth_usb.kicad_sch, programmer.kicad_sch, zynqMio.kicad_sch, zynq_test.kicad_sch]
2025-08-27 Added Cameras, changed SD card IC for skew reasons
    [Boot.kicad_sch, Cameras.kicad_sch, eth_usb.kicad_sch]
2025-08-31 Finished USB, started om ETH PHY
    [eth_usb.kicad_sch, ethernet.kicad_sch, usb_otg.kicad_sch, zynq_test.kicad_sch]
2025-09-01 Finished Ethernet, swapped FTDI chip for QFN
    [ZynqPWR+Config.kicad_sch, ethernet.kicad_sch, programmer.kicad_sch, zynqMio.kicad_sch, zynq_test.kicad_pcb]
2025-09-01 Finished HDMI
    [Boot.kicad_sch, HDMI.kicad_sch, ZynqBus.kicad_sch, ZynqDram.kicad_sch, ZynqPWR+Config.kicad_sch, ethernet.kicad_sch, programmer.kicad_sch, usb_otg.kicad_sch]
2025-09-03 Started on DDR3
    [ZynqDram.kicad_sch, zynqMio.kicad_sch, zynq_test.kicad_pcb]
2025-09-08 Connected DDR3, cleaned up some thing
    [Boot.kicad_sch, Cameras.kicad_sch, HDMI.kicad_sch, ZynqBus.kicad_sch, ZynqDram.kicad_sch, ZynqPWR+Config.kicad_sch, dram_pwr.kicad_sch, ethernet.kicad_sch]
2025-09-14 Finished Power Supply
    [Boot.kicad_sch, Cameras.kicad_sch, GPIO.kicad_sch, HDMI.kicad_sch, Power.kicad_sch, ZynqBus.kicad_sch, ZynqDram.kicad_sch, ZynqPWR+Config.kicad_sch]
2025-09-14 Finished most of the schematic, will start routing soon
    [Boot.kicad_sch, Cameras.kicad_sch, GPIO.kicad_sch, HDMI.kicad_sch, Power.kicad_sch, ZynqBus.kicad_sch, ethernet.kicad_sch, programmer.kicad_sch]
2025-10-03 Finished to first ddr ic
    [Cameras.kicad_sch, GPIO.kicad_sch, ZynqBus.kicad_sch, ZynqDram.kicad_sch, ZynqPWR+Config.kicad_sch, dram_pwr.kicad_sch, ethernet.kicad_sch, zynqMio.kicad_sch]
2025-10-05 DDR routed
    [ZynqDram.kicad_sch, ZynqPWR+Config.kicad_sch, dram_pwr.kicad_sch, zynq_test.kicad_pcb]
2025-10-25 finished diff of HDMI
    [Boot.kicad_sch, Cameras.kicad_sch, HDMI.kicad_sch, ZynqBus.kicad_sch, ZynqPWR+Config.kicad_sch, dram_pwr.kicad_sch, ethernet.kicad_sch, programmer.kicad_sch]
2025-11-16 Almost done with BOM
    [Boot.kicad_sch, CAMERA_TX.kicad_sch, Cameras.kicad_sch, GPIO.kicad_sch, HDMI.kicad_sch, Power.kicad_sch, RX_camera.kicad_sch, RX_camera_4ch.kicad_sch]
2025-11-17 Added pdf Schematics, updated readme
    [ZynqPWR+Config.kicad_sch]
2025-11-26 Version sent to JLCPCB
    [Boot.kicad_sch, CAMERA_TX.kicad_sch, Cameras.kicad_sch, GPIO.kicad_sch, HDMI.kicad_sch, Power.kicad_sch, RX_camera.kicad_sch, RX_camera_4ch.kicad_sch]
2025-11-26 Updated readme with schematics
    [zynq_test.csv-JLCPCB BOM Tool.xls, zynq_test_BOM.csv]
